baldengineer/Mixed-Signal-Oscilloscope-Demo-Board/EAGLE/MSO-demo-board.brd

## EAGLE design EAGLE/MSO-demo-board.brd (2013-09-24)

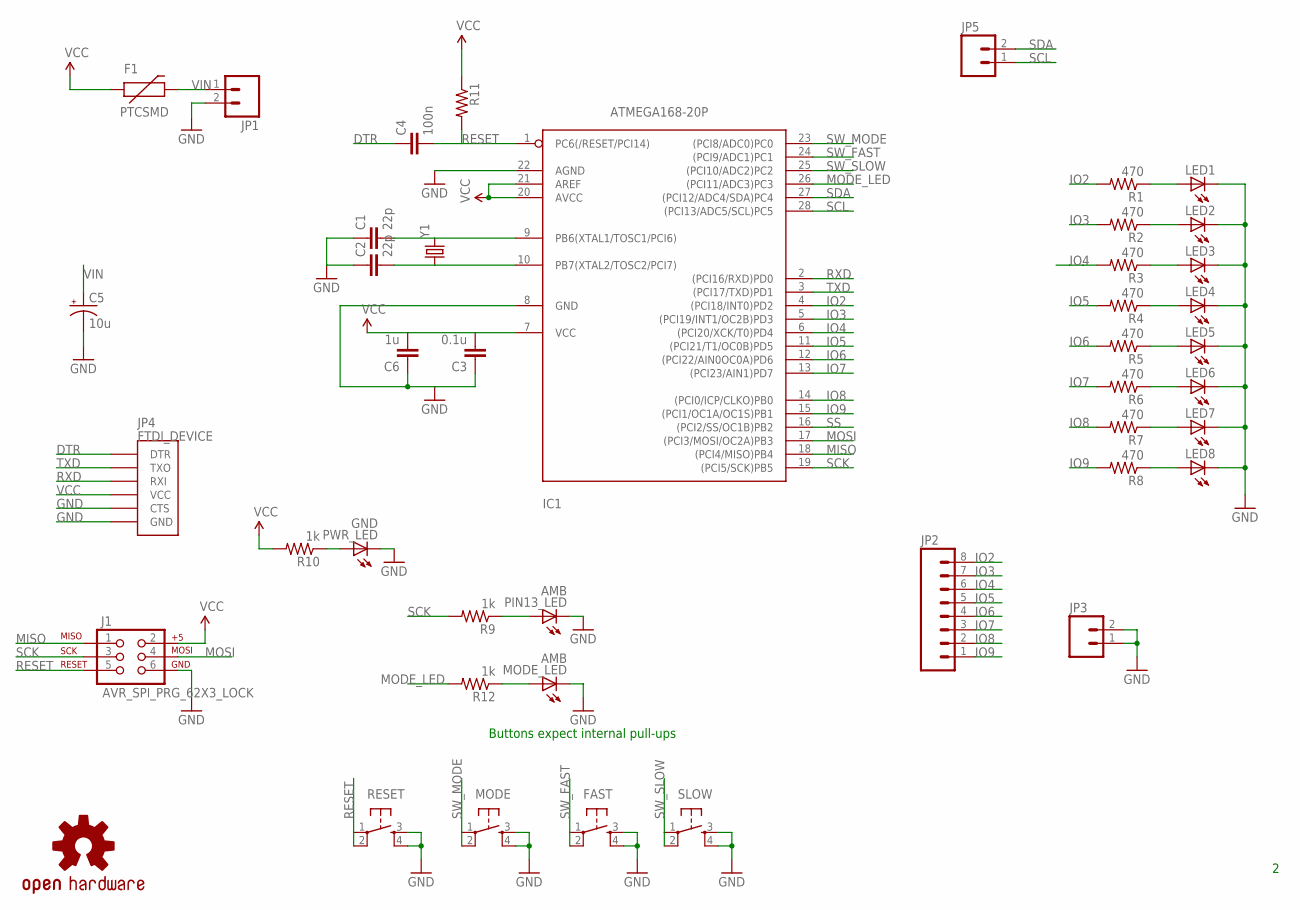
[picture p1: schematic MSO-demo-board.sch]

Parts:
C1, C2: 22p; 1206
C3: 0.1u; 1206
C4: 100n; 1206
C5: 10u; CT7343
C6: 1u; 1206
F1: PTCSMD; PTC-1206
FAST: TAC_SWITCHSMD; TACTILE_SWITCH_SMD
IC1: ATMEGA168-20P; DIL28-3
J1: AVR_SPI_PRG_62X3_LOCK; 2X3_LOCK
JP1, JP3, JP5: M02LOCK; 1X02_LOCK
JP2: M08LOCK; 1X08_LOCK
JP4: FTDI_DEVICE; FTDI_DEVICE_SIDE
LED1, LED2, LED3, LED4, LED5, LED6, LED7, LED8: LED1206; LED-1206
MODE: TAC_SWITCHSMD; TACTILE_SWITCH_SMD
MODE_LED: AMB; LED-1206
PIN13_LED: AMB; LED-1206
PWR_LED: GND; LED-1206
R1, R2, R3, R4, R5, R6, R7, R8: 470; 1206
R9, R10, R12: 1k; 1206
R11: RESISTOR1206; 1206
RESET: TAC_SWITCHSMD; TACTILE_SWITCH_SMD
SLOW: TAC_SWITCHSMD; TACTILE_SWITCH_SMD
U$1: OSHW-LOGOS; OSHW-LOGO-S
Y1: CRYSTALHC49UV; HC49U-V

Connections:
DTR: C4.1, JP4.P$1 (DTR)
GND: C1.1, C2.1, C3.1, C5.-, C6.1, FAST.3, FAST.4, IC1.8 (GND), IC1.22 (AGND), J1.6, JP1.2, JP3.1, JP3.2, JP4.P$5 (CTS), JP4.P$6 (GND), LED1.C, LED2.C, LED3.C, LED4.C, LED5.C, LED6.C, LED7.C, LED8.C, MODE.3, MODE.4, MODE_LED.C, PIN13_LED.C, PWR_LED.C, RESET.3, RESET.4, SLOW.3, SLOW.4
IO2: IC1.4 ((PCI18/INT0)PD2), JP2.8, R1.2
IO3: IC1.5 ((PCI19/INT1/OC2B)PD3), JP2.7, R2.2
IO4: IC1.6 ((PCI20/XCK/T0)PD4), JP2.6, R3.2
IO5: IC1.11 ((PCI21/T1/OC0B)PD5), JP2.5, R4.2
IO6: IC1.12 ((PCI22/AIN0OC0A)PD6), JP2.4, R5.2
IO7: IC1.13 ((PCI23/AIN1)PD7), JP2.3, R6.2
IO8: IC1.14 ((PCI0/ICP/CLKO)PB0), JP2.2, R7.2
IO9: IC1.15 ((PCI1/OC1A/OC1S)PB1), JP2.1, R8.2
MISO: IC1.18 ((PCI4/MISO)PB4), J1.1
MODE_LED: IC1.26 ((PCI11/ADC3)PC3), R12.2
MOSI: IC1.17 ((PCI3/MOSI/OC2A)PB3), J1.4
unnamed: PWR_LED.A, R10.1
unnamed: C1.2, IC1.9 (PB6(XTAL1/TOSC1/PCI6)), Y1.2
unnamed: C2.2, IC1.10 (PB7(XTAL2/TOSC2/PCI7)), Y1.1
unnamed: MODE_LED.A, R12.1
unnamed: PIN13_LED.A, R9.1
unnamed: LED1.A, R1.1
unnamed: LED3.A, R3.1
unnamed: LED2.A, R2.1
unnamed: LED4.A, R4.1
unnamed: LED5.A, R5.1
unnamed: LED6.A, R6.1
unnamed: LED7.A, R7.1
unnamed: LED8.A, R8.1
RESET: C4.2, IC1.1 (PC6(/RESET/PCI14)), J1.5, R11.2, RESET.1, RESET.2
RXD: IC1.2 ((PCI16/RXD)PD0), JP4.P$3 (RXI)
SCK: IC1.19 ((PCI5/SCK)PB5), J1.3, R9.2
SCL: IC1.28 ((PCI13/ADC5/SCL)PC5), JP5.1
SDA: IC1.27 ((PCI12/ADC4/SDA)PC4), JP5.2
SS: IC1.16 ((PCI2/SS/OC1B)PB2)
SW_FAST: FAST.1, FAST.2, IC1.24 ((PCI9/ADC1)PC1)
SW_MODE: IC1.23 ((PCI8/ADC0)PC0), MODE.1, MODE.2
SW_SLOW: IC1.25 ((PCI10/ADC2)PC2), SLOW.1, SLOW.2
TXD: IC1.3 ((PCI17/TXD)PD1), JP4.P$2 (TXO)
VCC: C3.2, C6.2, F1.1, IC1.7 (VCC), IC1.20 (AVCC), IC1.21 (AREF), J1.2, JP4.P$4 (VCC), R10.2, R11.1
VIN: C5.+, F1.2, JP1.1

Notes on the sheet:
Buttons expect internal pull-ups

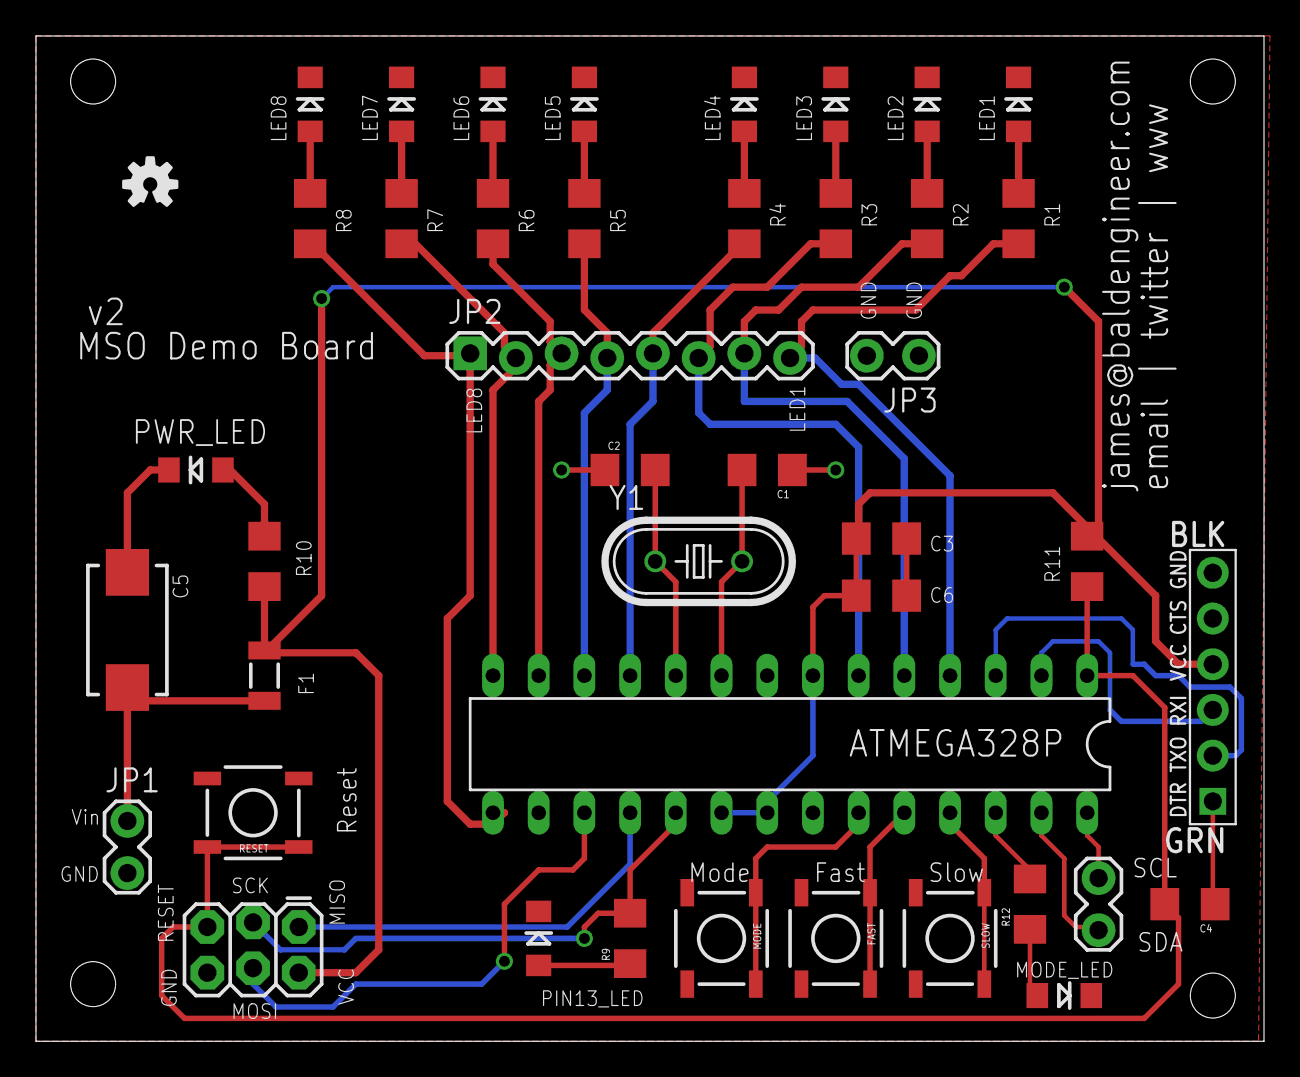
[picture p2: board MSO-demo-board.brd from above]

Board: 2 copper layers, 68.2 x 55.9 mm, 43 parts (0 on the bottom side), 37 nets.
