baldengineer/Mixed-Signal-Oscilloscope-Demo-Board/(commit log)

2013-08-26 Initial Commit
    Arduino Code and EAGLE R1 board.
    [MSO-demo-board.brd, MSO-demo-board.sch]
2013-08-26 Arduino IDE moved the file...
    …sigh.
2013-09-24 Added support for push buttons
    new pcb has push buttons, added support for them
2013-09-24 Fixed VCC Grounded mistake
    AVCC was tied to ground causing a short at power up. Tied AVCC and
    AREF to 5V instead of ground. Also swapped TX and RX on FTDI pinout
    (was backwards)
    [MSO-demo-board.brd, MSO-demo-board.sch]
